octoprobe/octohub4/README.rst

Octoprobe Octohub4
==================

This is the `documentation <http://www.octoprobe.org/octohub4>`_

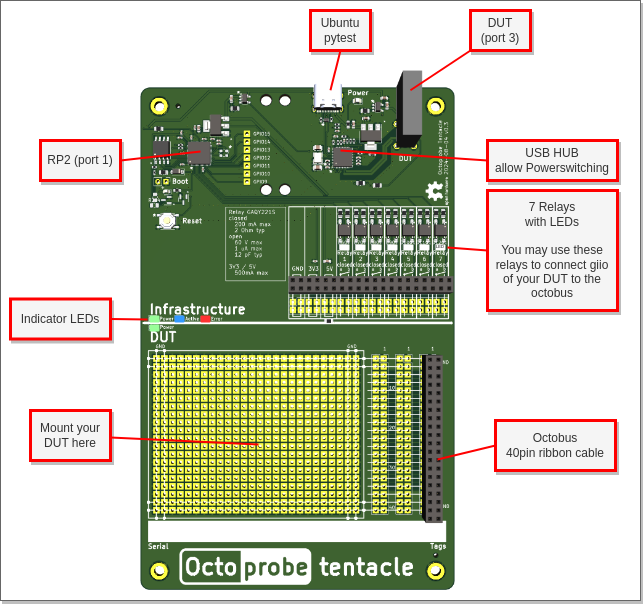
[picture p1: docs/tentacle_images/tentacle_intro.drawio.png]
