octoprobe/octohub4/kicad/octohub4_v0.2/README.md

# Octoprobe Octohub4 v0.1

octohub4

[schematics](octohub4_v0.1/schematics_octohub4_v0.1.pdf)

## History v0.1 -> v0.1 2026-01-05

 * PCB -> File -> Board Setup -> Design Rules -> Pre-defined Sizes -> Vias
   | Label | Before | New |
   | - | - | - |
   | Diameter | 0.4mm | 0.45mm |
   | Hole | 0.2mm | 0.3mm |

 * PCB -> File -> Board Setup -> Design Rules -> Constraints -> Minimum through hole

   * 0.2mm Before
   * 0.3mm New

 * PCB -> File -> Board Setup -> Design Rules -> Constraints -> Minimum annular width

   * 0.1mm Before
   * 0.075mm New

## History v0.1 -> v0.2

* Update pins names of TPS259474LRPWR in schematics

  * pin 2: OVLO

* New dimensioning of surrounding components of TPS25047
