octoprobe/octohub4/kicad/octohub4_v0.2/standoff_m3_16mm/README.txt

https://www.we-online.com/en/components/products/SBRIE_BRASS_SPACER_STUD_METRIC_INTERNAL_EXTERNAL
971160354
M3 x 16mm, 5mm wrench
