octoprobe/octohub4/kicad/octohub4_v0.2/standoff_m3_8mm/README.txt

https://www.we-online.com/en/components/products/SBRIE_BRASS_SPACER_STUD_METRIC_INTERNAL_EXTERNAL
971080324
M3 x 8mm, 5.5mm wrench
