octoprobe/octohub4/docs/index.rst

Octohub4
======================

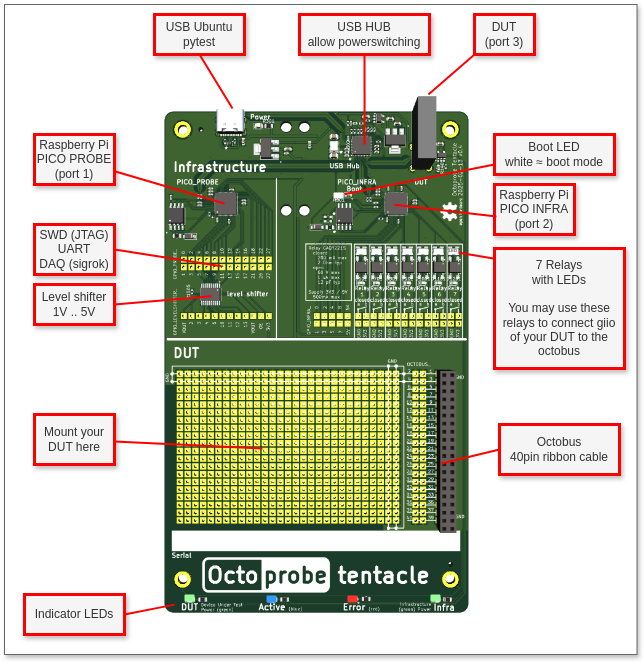
[picture p5: docs/tentacle_images/tentacle_intro_v0.4.drawio.png]


.. toctree::

    big_picture.rst
    pcb/bom.rst
    commissioning/commissioning.rst
    license.rst
