octoprobe/octohub4/kicad/octohub4_v0.2/production_v0.2/readme_errors_v0.2.md

# Errors on v0.1

## Update pins names of TPS259474LRPWR in schematics

* 2: OVLO <==
* 3: PG
* 4: PGTH
