octoprobe/octohub4/docs/tentacle_v0.6_images/kicad_top_background-white.png

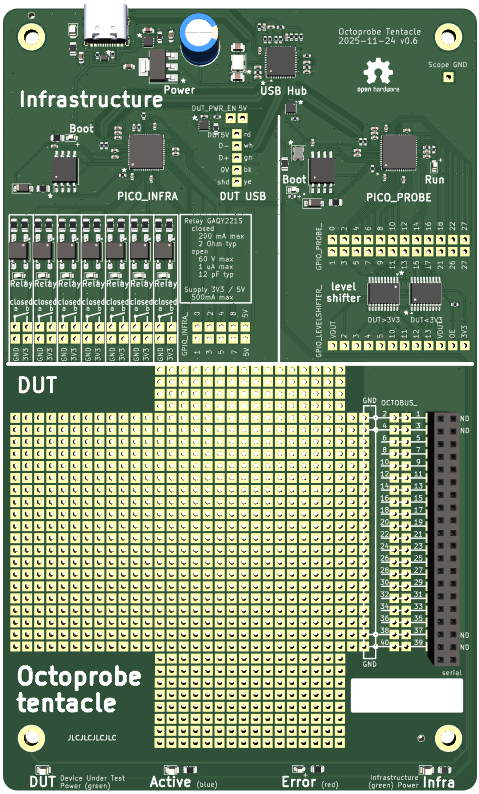
docs/tentacle_v0.6_images/kicad_top_background-white.png
