octoprobe/octohub4/docs/pcb/bom.rst

BOM (Bill of materials)
=========================================

Apart from the assembled PCB, these parts are required for a fully functional tentacle.

.. list-table:: Bill of materials
   :width: 50%
   :header-rows: 1

   * - Count
     - Image
     - Description

   * - 4
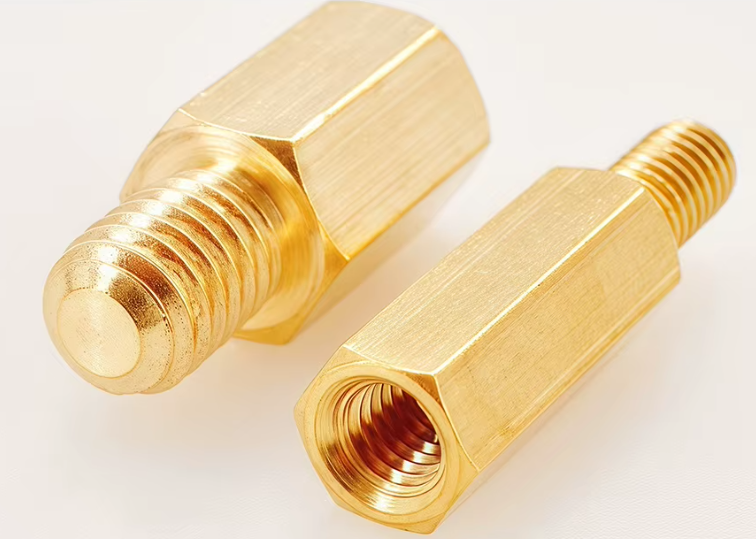
[picture p7: docs/pcb/bom_images/standoff_mount.png]
     - 
     - spring terminal
       https://de.aliexpress.com/item/1005008285877374.html

   * - 1
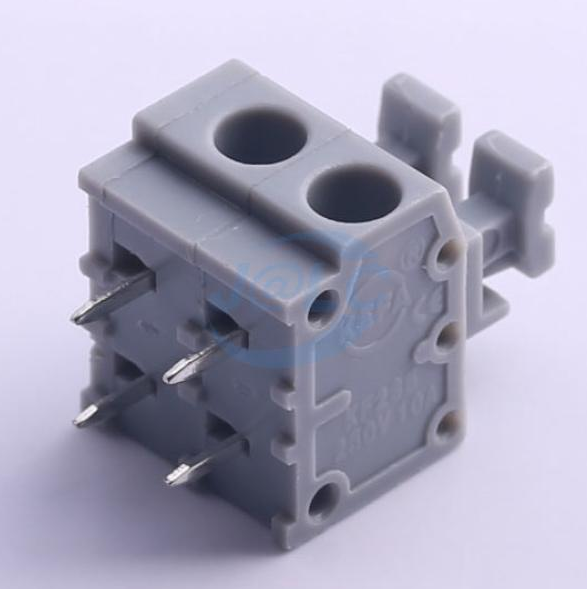
[picture p8: docs/pcb/bom_images/KF235-2P.png]
     - 
     - KF235-2P
       https://de.aliexpress.com/item/32890128819.html
       https://jlcpcb.com/partdetail/Cixi_KefaElec-KF235_5_02P/C475172

   * - 1
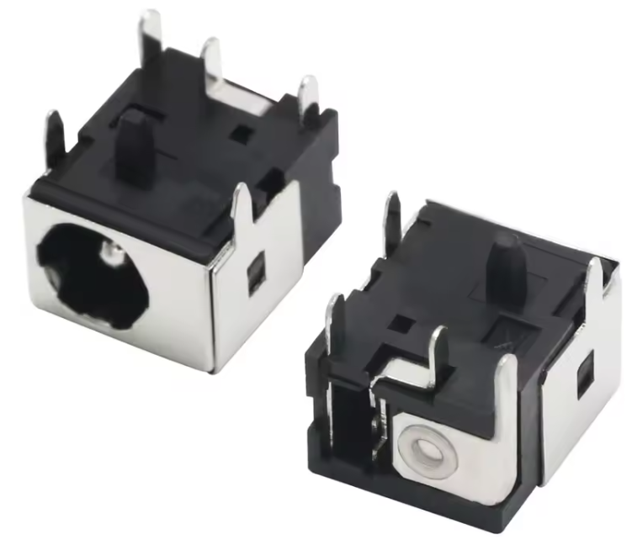
[picture p9: docs/pcb/bom_images/barrel_jack.png]
     - 
     - Ø 5.5mm barrel jack
       https://de.aliexpress.com/item/1005007327587937.html
       https://jlcpcb.com/partdetail/XKBConnection-DC_044A_2_5A_20/C319095
       https://www.helloxkb.com/Home/Goods/goodsInfoxq/id/23915.html

   * - 1
     - 
     - Bulk Capacitor 500-1000uF
       https://www.digikey.de/en/products/detail/w%C3%BCrth-elektronik/860010273011/5726952
