octoprobe/octohub4/evaluation/components/TPS25047.md

* TPS259474LRPWR

* https://www.ti.com/product/TPS25947

* https://www.ti.com/lit/gpn/tps25947

* https://www.ti.com/product/TPS25947#design-tools-simulation

  * https://www.ti.com/tool/download/SLVRBH5

    * SLVRBH5 — TPS25947 Design Calculator (Excel Sheet)

## Calculations

VIN(UV) = (VUVLO × (R1 + R2)  / R2

According to 9.3.1 Design Requirements

| Parameter | Value Example | Value octohub4 |
| - | - | - |
| Input supply voltage (VIN) | 12 V | - |
| Undervoltage threshold (VIN(UV)) | 10.8 V | - |
| Overvoltage threshold (VIN(OV)) | 13.2 V | - |
| Output power good threshold (VPG) | 11.4 V | - |
| Max continuous current | 5.5 A | - |
| Load transient blanking interval (tITIMER) | 2 ms | - |
| Output capacitance (COUT) | 470 μF | - |
| Output rise time (tR) | 20 ms | - |
| Overcurrent threshold (ILIM) | 6A | - |
| Overcurrent response | Circuit breaker | - |
| Fault response | Latch off | - |

## Terms

Overcurrent protection with load current monitor output (ILM)

Active high enable input with adjustable undervoltage lockout threshold (UVLO)

Adjustable OVLO: Adjustable overvoltage lockout (OVLO)

PG:

PGTH:

## SLVRBH5 — TPS25947 Design Calculator (Excel Sheet)

Libre Office Calc

Tool -> Options -> Security -> Macro Security -> "High" ==> "Medium"

After setting "TPS259474L" in "Calculation Sheet", the Macro has to be started manually.
This dialog box appears: `TPS259474X has Programmable UVLO & OVLO,Circuit Breaker,PG,PGTH`
