octoprobe/octohub4/evaluation/components/barrel_plug.md

## https://www.dlink.com/de/de/products/dub-h7-7-port-usb-2-0-hub

Gemini:

    The D-Link DUB-H7 7-Port USB 2.0 Hub typically uses a standard DC barrel plug with the following dimensions:

    * Outer Diameter (OD): 5.5 mm
    * Inner Diameter (ID): 2.1 mm
    * Polarity: Center Positive (+)

## Power supplies

* https://www.brack.ch/exsys-steckernetzteil-ex-6997-20-w-654446

  chf25, 20W

* https://www.brack.ch/alpha-elettronica-steckernetzteil-20-w-618739

  chf25, 20W

* https://www.brack.ch/alpha-elettronica-tischnetzgeraet-25-w-98010

  chf44, 25W

* https://www.galaxus.ch/de/s1/product/rs-pro-steckernetzteil-90-264v-ac-5v-dc-8a-iec-320-c14-anschluss-universalladegeraet-23917422
  
  chf35, 40W

* https://www.galaxus.ch/de/s1/product/meanwell-tischnetzteil-30w-5v-universalladegeraet-34608264

  ch35, 30W

* https://www.galaxus.ch/de/s4/product/meanwell-mpm-65-5st-netzteil-spannungsumwandler-indoor-65-w-schwarz-spannungswandler-15913003

  chf33, 65W, Schraubklemmen

## JLCPCB

Search strings:

* connector dc power jack

https://jlcpcb.com/partdetail/Korean_HropartsElec-DC_005C25A/C223903
    Korean Hroparts Elec

https://jlcpcb.com/partdetail/GANGYUAN-DC_470_20GP/C194406

    GANGYUAN

https://jlcpcb.com/partdetail/XKBConnection-DC_044A_2_5A_25/C319094

    XKB Connection
    With Switch
    2.5/5.5mm

https://jlcpcb.com/partdetail/XKBConnection-DC_044A_2_5A_20/C319095

    XKB Connection
    With Switch
    2.1/5.5mm
    USD0.3
    https://www.helloxkb.com/Home/Goods/goodsInfoxq/id/23915.html

    <<=== SELECTED

    compatible with
    https://www.digikey.ch/en/products/detail/tensility-international-corp/54-00127/9685436

    https://de.aliexpress.com/item/1005008534687632.html

https://jlcpcb.com/partdetail/XKBConnection-DC_0360_25/C319122

    XKB Connection
    Without Switch

https://jlcpcb.com/partdetail/XKBConnection-DC_003A_2A_10/C319135

    XKB Connection
    Without Switch

https://jlcpcb.com/partdetail/XKBConnection-DC_042C_W_20/C381108

    XKB Connection
    8A !

https://jlcpcb.com/partdetail/SOFNG-DC_036AT20/C428474

    SOFNG
    3A !

## DigiKey

https://www.digikey.ch/en/products/detail/tensility-international-corp/54-00127/9685436

    Tensility International Corp
    With Switch
    6A !
    chf0.6
    **Asymetric, robust**

https://www.digikey.ch/en/products/detail/tensility-international-corp/54-00133/9685442

    Tensility International Corp
    6A !
    chf0.8
    **Symmetric, but asymmetric pins**
