octoprobe/octohub4/evaluation/components/screwless_terminal.md

# Screwless terminal

## JLCPCB

* https://jlcpcb.com/partdetail/Cixi_KefaElec-KF235_5_02P/C475172

  Ningbo Kangnex Elec
  3k
  USD0.15
  5mm distance

  ***SELECTION

* https://jlcpcb.com/partdetail/36591-WJ142R_5_08_02P_1400A/C35616

  18k
  USD0.20
  5.08mm distance

* https://jlcpcb.com/partdetail/Cixi_KefaElec-KF243_5_02P/C475222

  Cixi Kefa Elec
  71k
  USD0.26
  5mm distance

* https://jlcpcb.com/partdetail/Ningbo_Xinlaiya_Elec-XY119A_5_02P/C784939

  Ningbo Xinlaiya Elec.
  4k
  USD0.20
  5mm distance

* https://jlcpcb.com/partdetail/Ningbo_Xinlaiya_Elec-XY115A_5_02P/C784935

  6k
  Ningbo Xinlaiya Elec.
  USD0.30
  5mm distance

* https://jlcpcb.com/partdetail/Ningbo_Xinlaiya_Elec-XY118_5_02P/C784922

  60k
  Ningbo Xinlaiya Elec.
  USD0.22
  5mm distance

* https://jlcpcb.com/partdetail/Cixi_KefaElec-KF243A_5_02P/C475212

  Cixi Kefa Elec
  38k
  USD0.18
  5mm distance

## Aliexpress

* [KF235-2P](https://de.aliexpress.com/item/32892631950.html)

  5mm distance
  2x2pin 5x5mm
  USD16/100

* [KF235-2P](https://de.aliexpress.com/item/32831490528.html)

  5mm distance
  2x2pin 5x5mm
  USD7/10

* [KF235-2P](https://de.aliexpress.com/item/1005002932348888.html)

  5mm distance
  2x2pin 5x5mm
  USD3/3

* [KF235-2P](https://de.aliexpress.com/item/32890128819.html)

  5mm distance
  2x2pin 5x5mm
  USD1/20

  ***SELECTION
