octoprobe/octohub4/kicad/octohub4_v0.2/00_project_parts/KF235-2P/README.txt

https://www.digikey.in/en/products/detail/wago-corporation/236-402/15573417
