octoprobe/octohub4/evaluation/components/usbA_plug.md

# USB A plug flat

https://jlcpcb.com/partdetail/2722-901211A1021D10100/C2346
  Jing Extension of the Electronic Co.
  48k
  USD0.04

https://jlcpcb.com/partdetail/2721-902131A1011D10100/C2345
  Jing Extension of the Electronic Co.
  57k
  USD0.05

https://jlcpcb.com/partdetail/2720-902131A1021D10100/C2344
  Jing Extension of the Electronic Co
  7k
  USD0.05

https://jlcpcb.com/partdetail/XUNPU-USB_231ARY/C720525
  XUNPU
  37k
  USD0.13

  Tentacle v0.3:  C720524

  ***SELECTION
