octoprobe/octohub4/kicad/octohub4_v0.2/00_project_parts/bizcard/footprints/TYPE-C-31-M-12--3DModel-STEP-56544.STEP

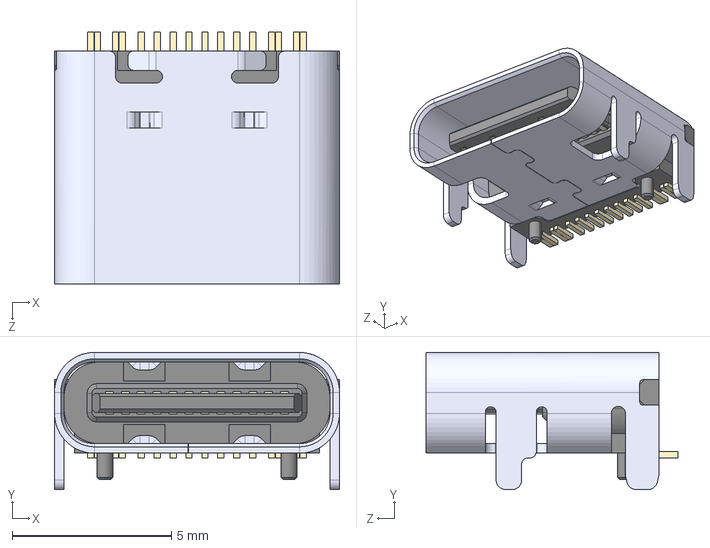
[picture p10: CAD file, 2026-01-20]
kicad/octohub4_v0.2/00_project_parts/bizcard/footprints/TYPE-C-31-M-12--3DModel-STEP-56544.STEP
8.94 x 4.30 x 7.90 mm
