octoprobe/octohub4/kicad/octohub4_v0.2/00_project_parts/KF235-2P/KF235-2P.step

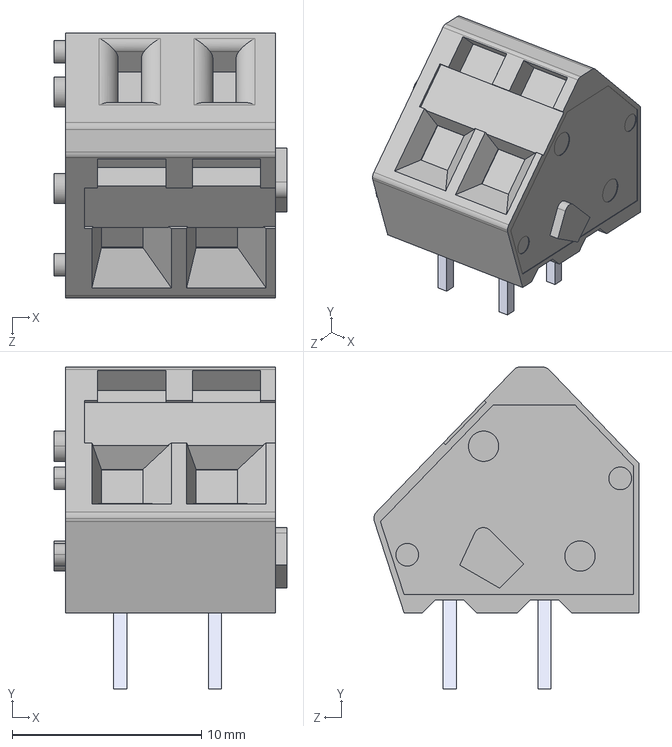
[picture p11: CAD file, 2026-01-20]
kicad/octohub4_v0.2/00_project_parts/KF235-2P/KF235-2P.step
12.3 x 17.0 x 14.0 mm
