octoprobe/octohub4/kicad/octohub4_v0.2/00_project_parts/TPS259474LRPWR/VQFN-HR-10P.step

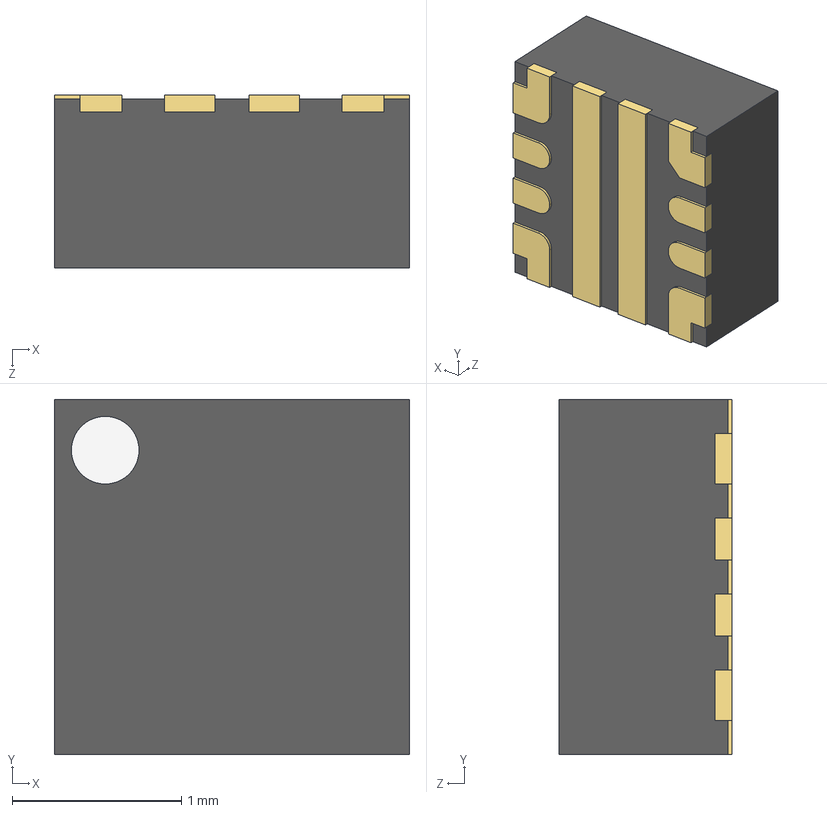
[picture p12: CAD file, 2026-01-20]
kicad/octohub4_v0.2/00_project_parts/TPS259474LRPWR/VQFN-HR-10P.step
2.10 x 2.10 x 1.02 mm
