octoprobe/octohub4/kicad/octohub4_v0.2/00_project_parts/USB_A/USB-226-BRW/USB-226-BRW.stp

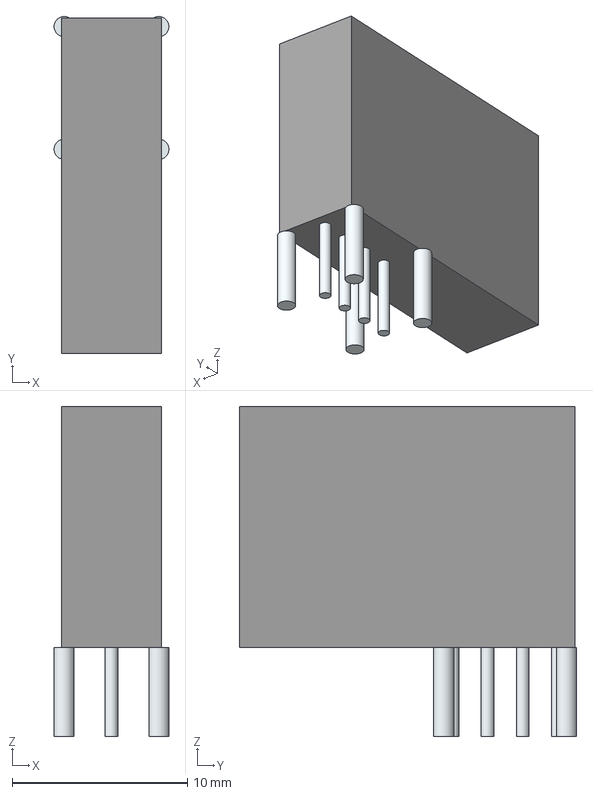
[picture p13: CAD file, 2026-01-20]
kicad/octohub4_v0.2/00_project_parts/USB_A/USB-226-BRW/USB-226-BRW.stp
6.55 x 19.2 x 18.9 mm
Leads
