octoprobe/octohub4/kicad/octohub4_v0.2/standoff_m3_16mm/standoff_m3_16mm.stp

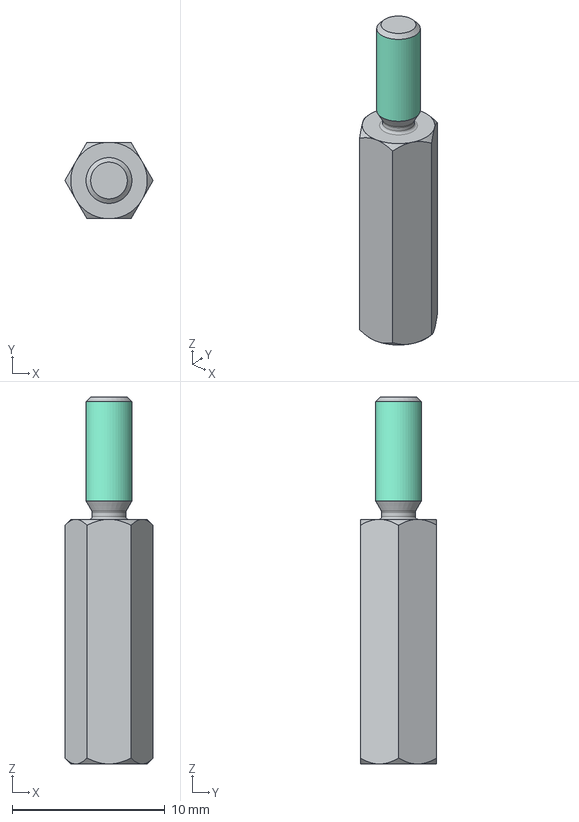
[picture p14: CAD file, 2026-01-20]
kicad/octohub4_v0.2/standoff_m3_16mm/standoff_m3_16mm.stp
5.77 x 5.00 x 24.0 mm
