octoprobe/octohub4/kicad/octohub4_v0.2/standoff_m3_8mm/standoff_m3_8mm.stp

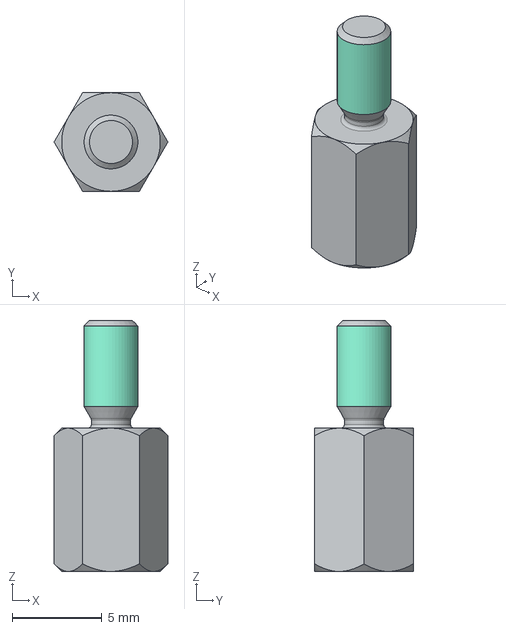
[picture p15: CAD file, 2026-01-20]
kicad/octohub4_v0.2/standoff_m3_8mm/standoff_m3_8mm.stp
6.35 x 5.50 x 14.0 mm
