octoprobe/octohub4/kicad/octohub4_v0.2/00_project_parts/bizcard/footprints/TS-1187A-B-A-B.step

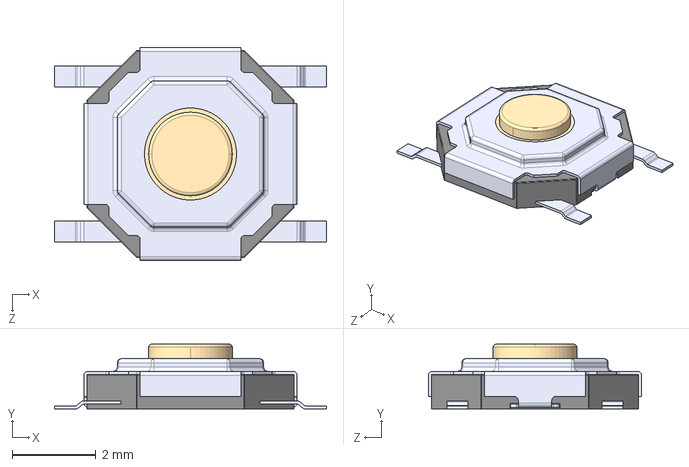
[picture p16: CAD file, 2026-01-20]
kicad/octohub4_v0.2/00_project_parts/bizcard/footprints/TS-1187A-B-A-B.step
6.50 x 1.55 x 5.10 mm
