octoprobe/octohub4/(list of files, cad)

Other CAD files:
kicad/octohub4_v0.2/standoff_m3_16mm/standoff_m3_16mm.igs
kicad/octohub4_v0.2/standoff_m3_8mm/standoff_m3_8mm.igs
