octoprobe/octohub4/evaluation/layout/layout_evaluation.md

## USB A

* upright

  * \- stack with 5 hubs get quite high
  * \+ 40 pin connecter as with tentacle
  * \+ bolzone as with tentacle

* flat

  * \+ stack with 5 hubs is more compact
  * \+ reduces mail cost as letter thickness
  * \- 40 pin connecter does not fit
  * \- bolzone does not fit

* flat with brass spacers

  * https://ch.farnell.com/harwin/r30\-3002002/abstandhalter\-6kant\-a\-i\-messing/dp/3754518
  * TODO: \+ Outside: 4 nylon spacers
  * Insice: 1 spacer with 

  * \+ very compact and robust
  * \+ cheap (no 40 pin connector needed)
  * \- disassembly pcb by pcb
  * \- risk of short circuit
  * \+- DC connector only on top pcb
