octoprobe/octohub4/kicad/octohub4_v0.2/production_v0.2/schematics_octohub4_v0.1.pdf

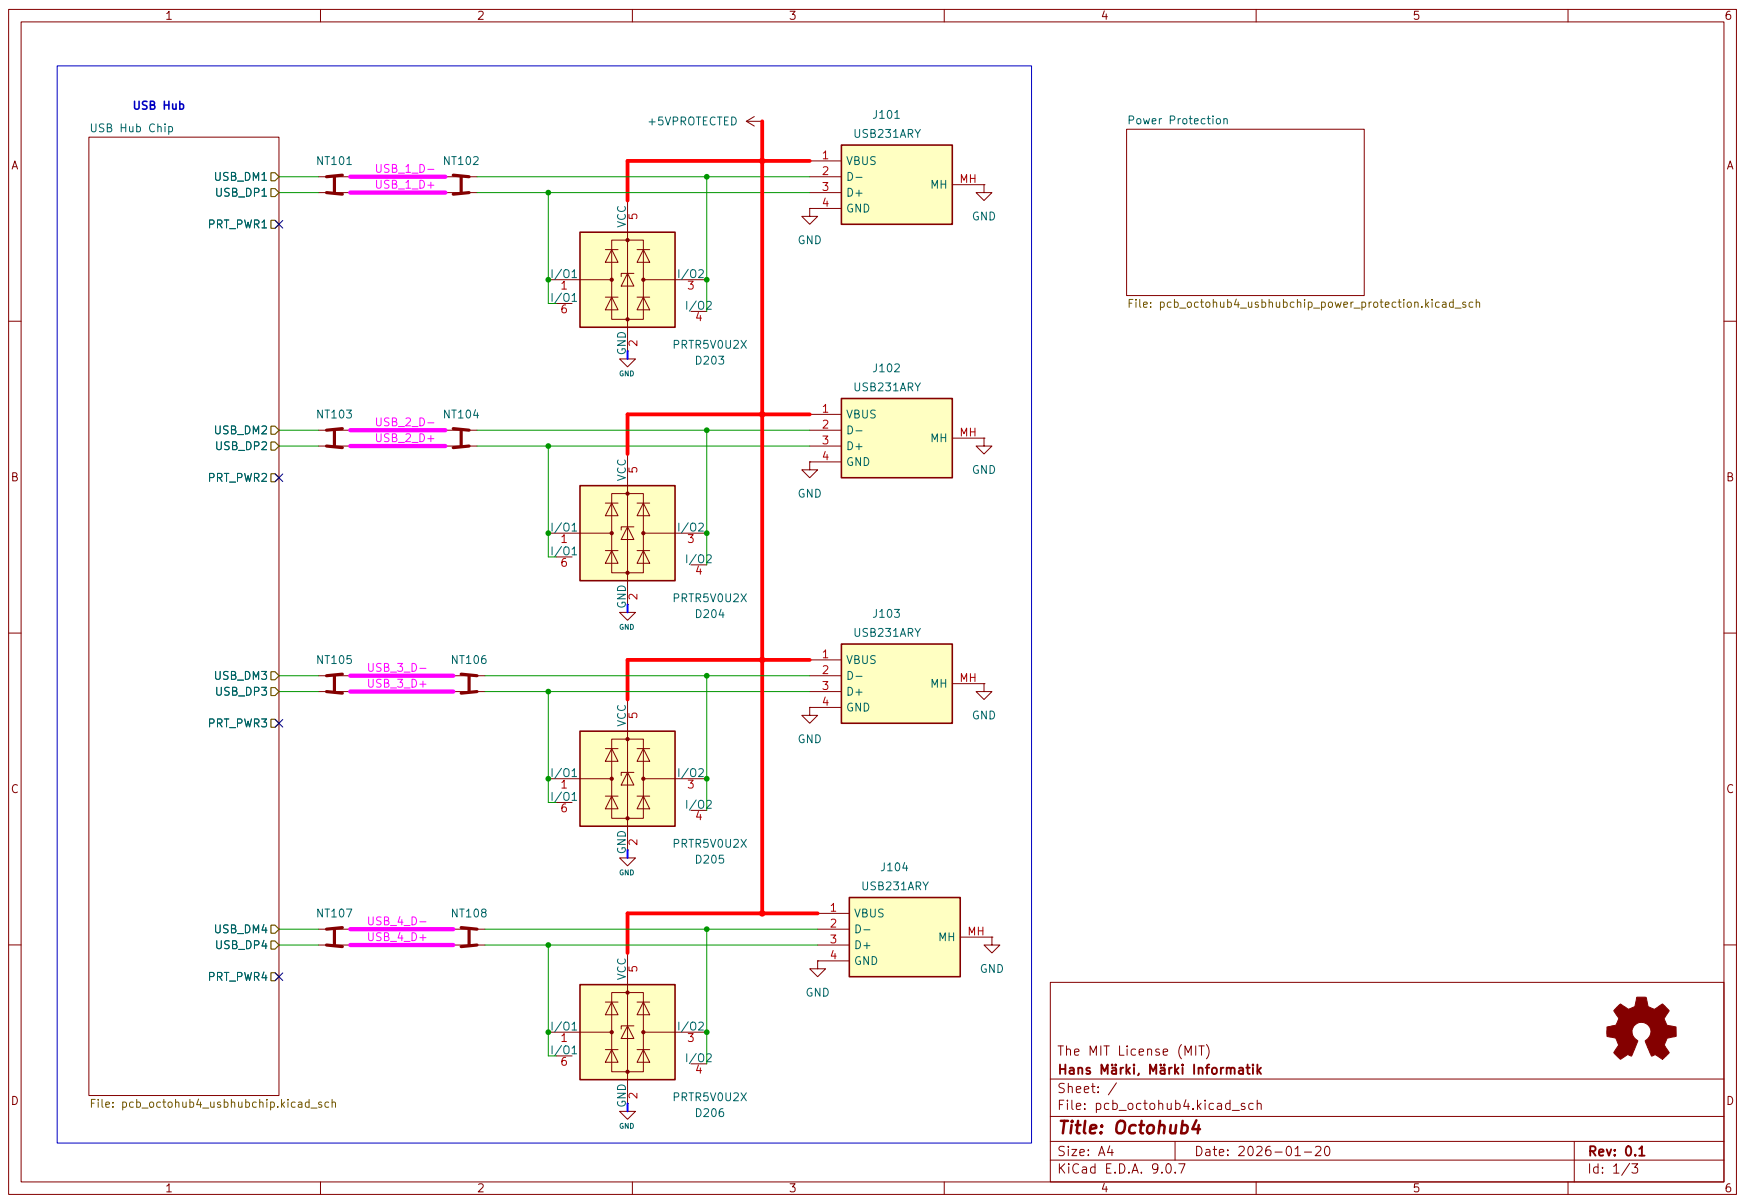
[picture p17: page 1]

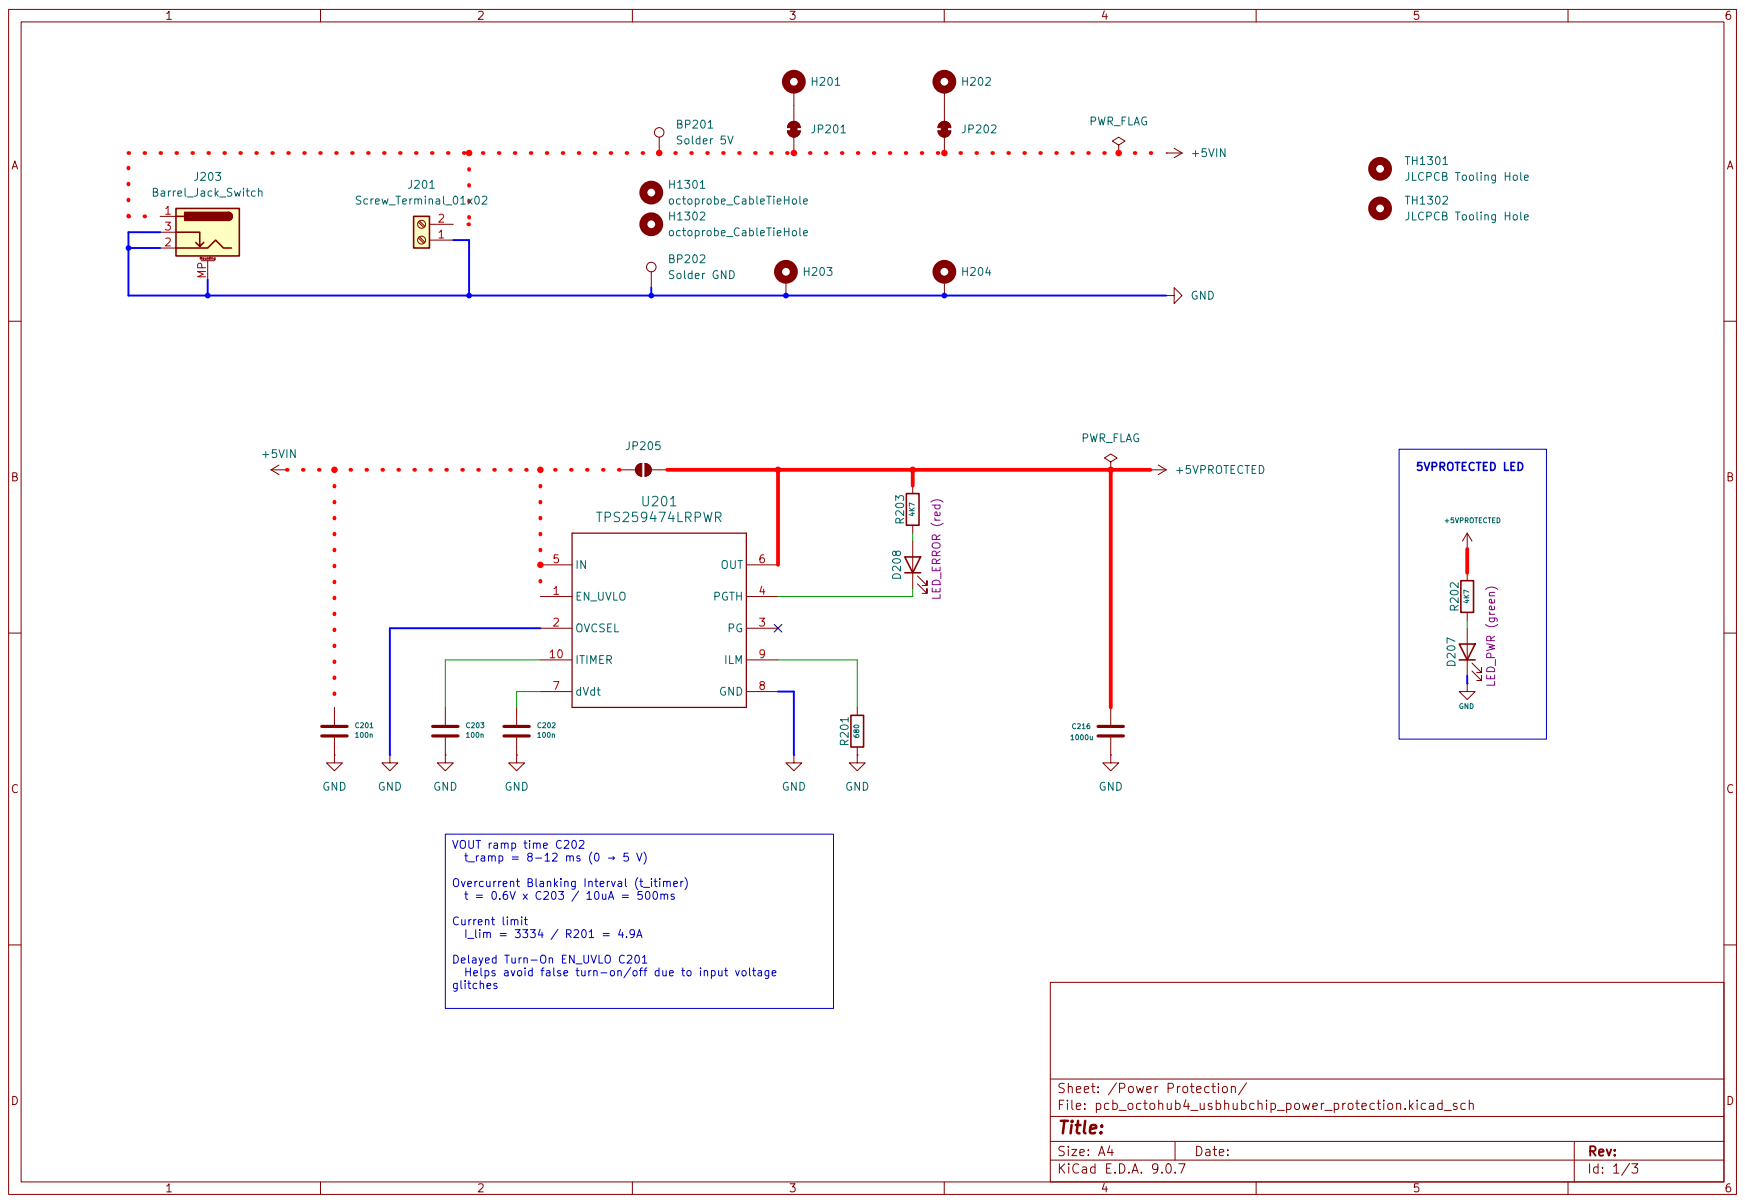
[picture p18: page 2]

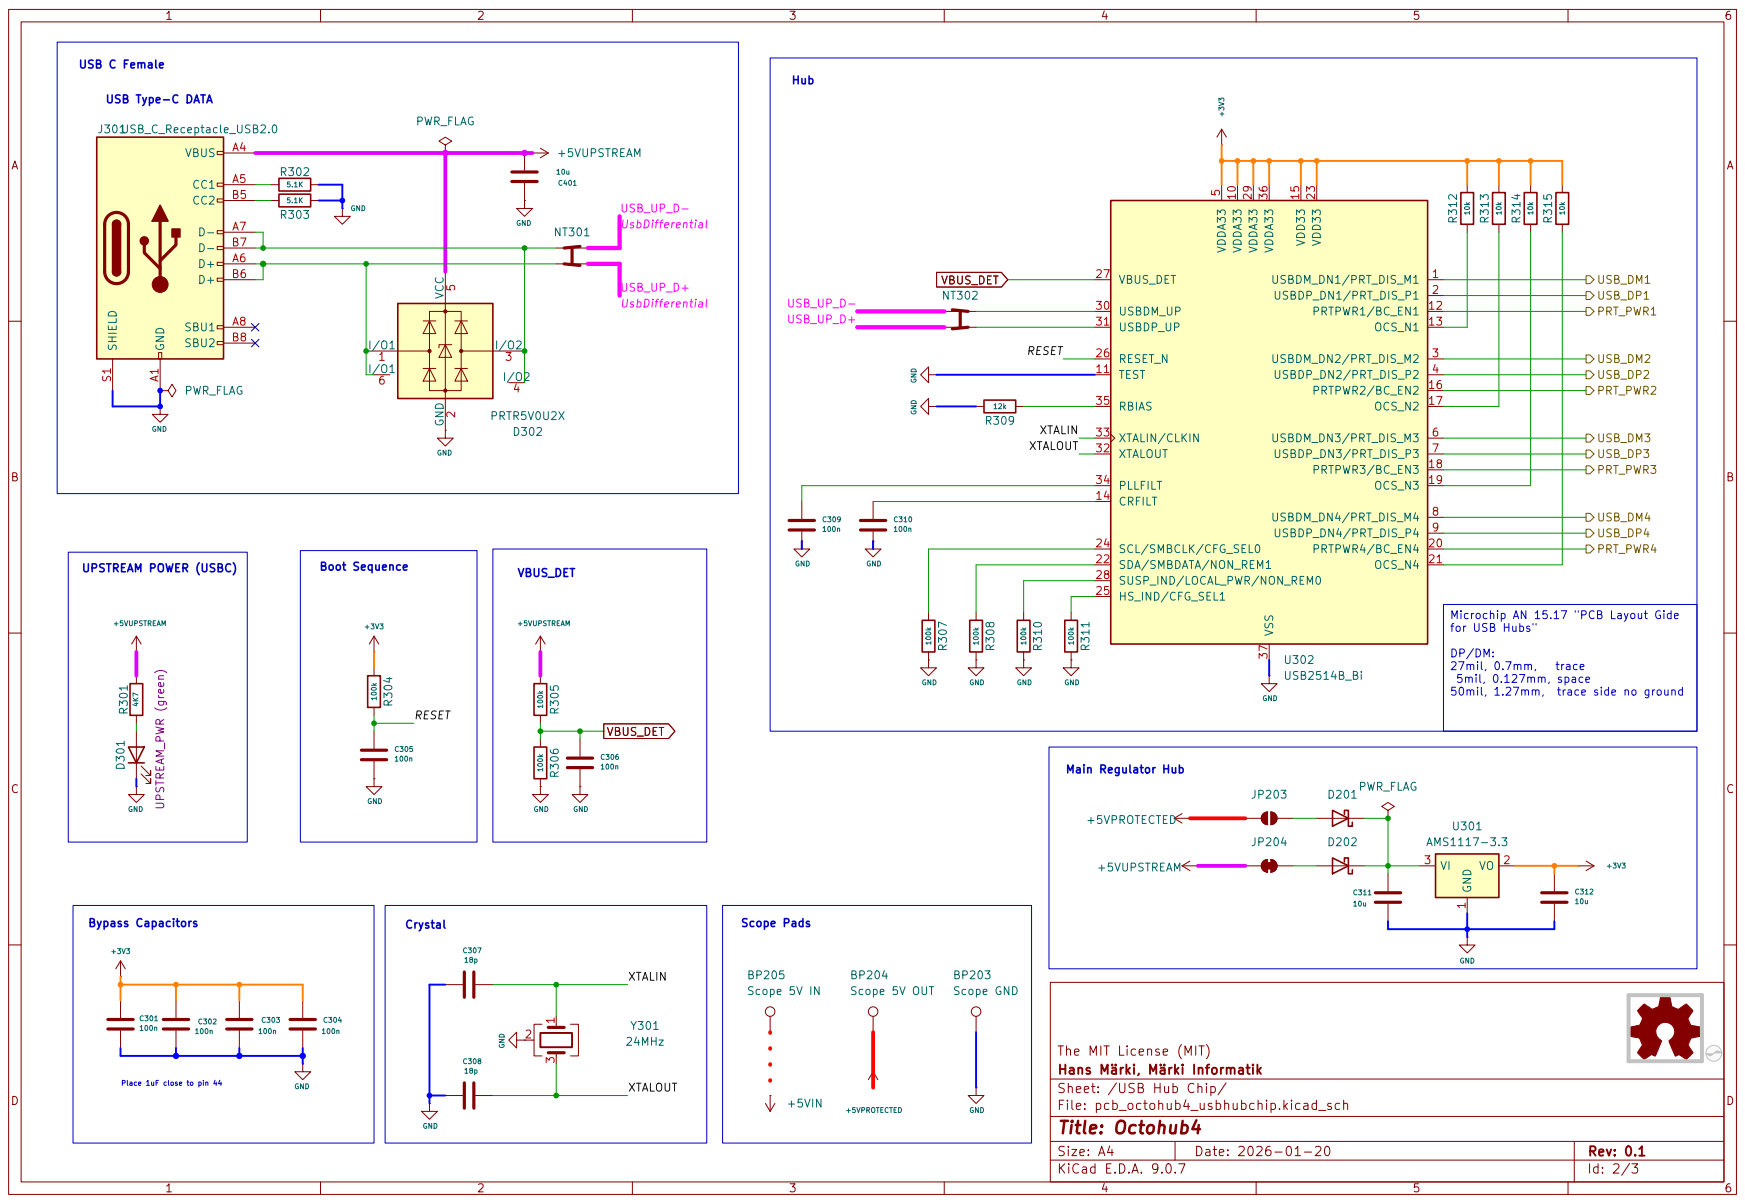
[picture p19: page 3]
