octoprobe/octohub4/(commit log)

2026-01-20 Initial commit: octohub4 v0.1
    [KF235-2P.step, TS-1187A-B-A-B.step, TYPE-C-31-M-12--3DModel-STEP-56544.STEP, USB-226-BRW.stp, VQFN-HR-10P.step, bom.csv, designators.csv, pcb_octohub4.kicad_pcb]
2026-02-05 New via constraints: Copy usb hub footprint from tentacle v0.7
    [pcb_octohub4.kicad_pcb, pcb_octohub4_usbhubchip.kicad_sch]
2026-02-05 Version v0.1. Manually fix all violations.
    [pcb_octohub4.kicad_pcb, positions.csv]
2026-02-15 Update documentation
    [TPS25947xx_Design_Calculator.xlsm]
2026-02-15 cp -r octohub4_v0.1/ octohub4_v0.2
    [KF235-2P.step, TS-1187A-B-A-B.step, TYPE-C-31-M-12--3DModel-STEP-56544.STEP, USB-226-BRW.stp, VQFN-HR-10P.step, bom.csv, designators.csv, pcb_octohub4.kicad_pcb]
2026-02-15 Update rev 0.2
    [pcb_octohub4.kicad_pcb, pcb_octohub4.kicad_sch, pcb_octohub4_usbhubchip.kicad_sch]
2026-02-15 v0.2: Update schematics and layout
    [pcb_octohub4.kicad_pcb, pcb_octohub4_usbhubchip_power_protection.kicad_sch]
2026-02-16 Recalculate all resistors around TPS25047
    [pcb_octohub4.kicad_pcb, pcb_octohub4_usbhubchip_power_protection.kicad_sch]
