octoprobe/octohub4/(notices)

Notices in the files:
kicad/octohub4_v0.2/pcb_octohub4_usbhubchip.kicad_sch:
The MIT License (MIT)
